jeanli-pix/test_cansat_2627/Diagramme_UML_CANSAT_2627.pdf

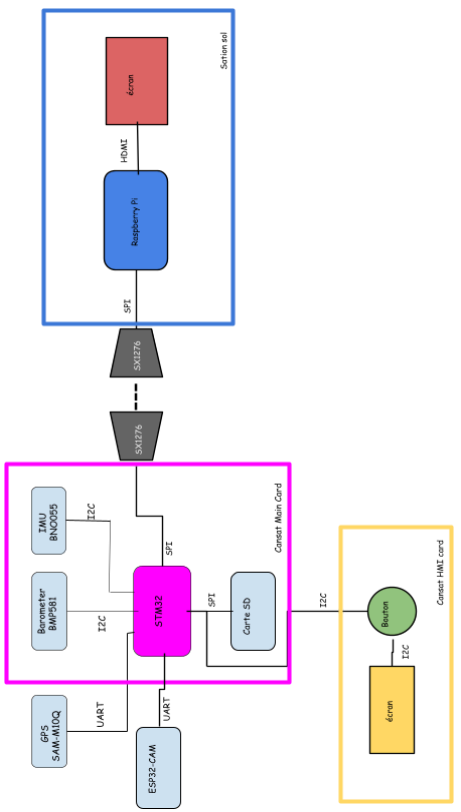
[picture p3: figure]
