jeanli-pix/test_cansat_2627/Cansat_PCB_V3/Cansat_PCB_V3.kicad_sch

## KiCad design Cansat_PCB_V3/Cansat_PCB_V3.kicad_sch (2026-11-03)

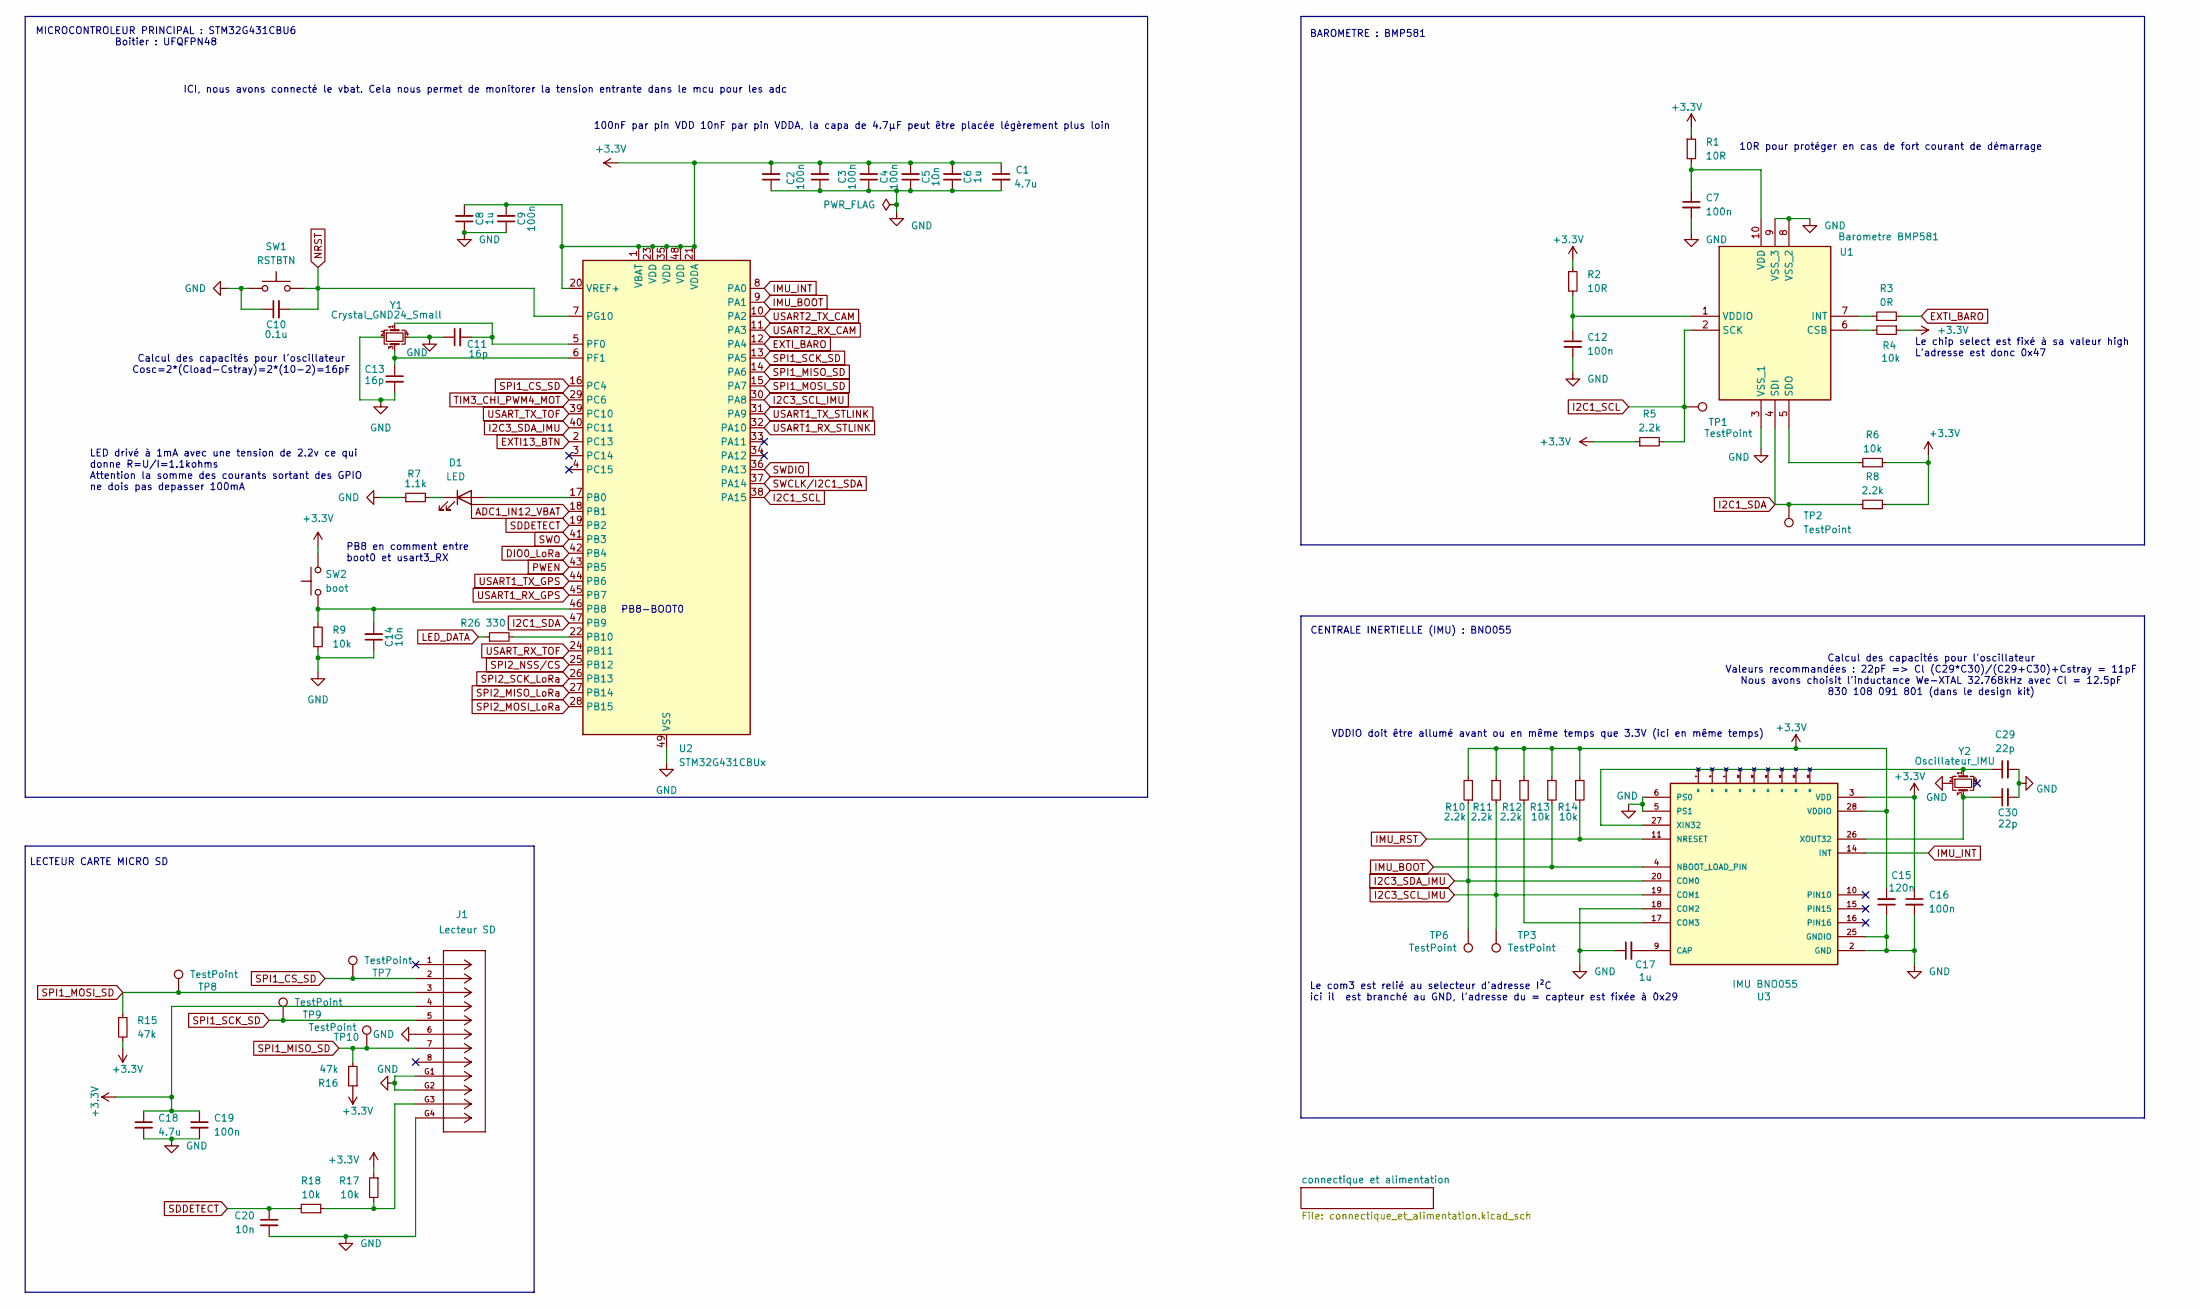
[picture p6: schematic Cansat_PCB_V3.kicad_sch]

Parts:
C1, C18: 4.7u; C_0402_1005Metric_Pad0.74x0.62mm_HandSolder
C2, C3, C4, C7, C9, C12, C16, C19: 100n; C_0402_1005Metric_Pad0.74x0.62mm_HandSolder
C5, C14, C20: 10n; C_0402_1005Metric_Pad0.74x0.62mm_HandSolder
C6, C8, C17: 1u; C_0402_1005Metric_Pad0.74x0.62mm_HandSolder
C10: 0.1u; C_0402_1005Metric_Pad0.74x0.62mm_HandSolder
C11, C13: 16p; C_0402_1005Metric_Pad0.74x0.62mm_HandSolder
C15: 120n; C_0402_1005Metric_Pad0.74x0.62mm_HandSolder
C29, C30: 22p; C_0402_1005Metric_Pad0.74x0.62mm_HandSolder
D1: LED; LED_0603_1608Metric_Pad1.05x0.95mm_HandSolder
J1: Lecteur SD; CONN12_47309-2651_MOL; Manufacturer_Part_Number 47309-2651
R1, R2: 10R; R_0402_1005Metric_Pad0.72x0.64mm_HandSolder
R3: 0R; R_0402_1005Metric_Pad0.72x0.64mm_HandSolder
R4, R6, R9, R13, R14, R17, R18: 10k; R_0402_1005Metric_Pad0.72x0.64mm_HandSolder
R5, R8, R10, R11, R12: 2.2k; R_0402_1005Metric_Pad0.72x0.64mm_HandSolder
R7: 1.1k; R_0402_1005Metric_Pad0.72x0.64mm_HandSolder
R15, R16: 47k; R_0402_1005Metric_Pad0.72x0.64mm_HandSolder
R26: 330; R_0402_1005Metric_Pad0.72x0.64mm_HandSolder
SW1: RSTBTN; KXT 321 LHS_CNK
SW2: boot; KXT 321 LHS_CNK
TP1, TP2, TP3, TP6, TP7, TP8, TP9, TP10: TestPoint; TestPoint_Pad_D1.0mm
U1: Barometre BMP581; BMP581; Manufacturer_Part_Number BMP581; Mouser Part Number 262-BMP581
U2: STM32G431CBUx; QFN-48-1EP_7x7mm_P0.5mm_EP5.6x5.6mm
U3: IMU BNO055; LGA28R50P4X10_380X520X100; Manufacturer_Part_Number BNO055; Mouser Part Number 262-BNO055
Y1: Crystal_GND24_Small; Crystal_SMD_3225-4pin_3.2x2.5mm
Y2: Oscillateur_IMU; WE-XTAL_IQXC-146

Connections:
+3.3V: C1.1, C2.2, C3.2, C4.2, C5.2, C6.2, C8.2, C9.2, C15.2, C16.1, C18.1, C19.1, J1.4, R1.1, R2.1, R4.1, R5.1, R6.2, R8.2, R10.2, R11.1, R12.1, R13.1, R14.1, R15.2, R16.1, R17.1, SW2.2, U2.1 (VBAT), U2.20 (VREF+), U2.21 (VDDA), U2.23 (VDD), U2.35 (VDD), U2.48 (VDD), U3.3 (VDD), U3.28 (VDDIO)
ADC1_IN12_VBAT: U2.18 (PB1)
DIO0_LoRa: U2.42 (PB4)
EXTI13_BTN: U2.2 (PC13)
EXTI_BARO: R3.2, U2.12 (PA4)
GND: C1.2, C2.1, C3.1, C4.1, C5.1, C6.1, C7.2, C8.1, C9.1, C10.1, C11.1, C12.2, C13.2, C14.1, C15.1, C16.2, C17.1, C18.2, C19.2, C20.2, C29.2, C30.2, J1.6, J1.G1, J1.G2, J1.G4, R7.1, R9.2, SW1.1, U1.3 (VSS_1), U1.8 (VSS_2), U1.9 (VSS_3), U2.49 (VSS), U3.2 (GND), U3.5 (PS1), U3.6 (PS0), U3.18 (COM2), U3.25 (GNDIO), Y1.2, Y1.4, Y2.2
I2C1_SCL: R5.2, TP1.1, U1.2 (SCK), U2.38 (PA15)
I2C1_SDA: R8.1, TP2.1, U1.4 (SDI), U2.47 (PB9)
I2C3_SCL_IMU: R11.2, TP3.1, U2.30 (PA8), U3.19 (COM1)
I2C3_SDA_IMU: R10.1, TP6.1, U2.40 (PC11), U3.20 (COM0)
IMU_BOOT: R13.2, U2.9 (PA1), U3.4 (NBOOT_LOAD_PIN)
IMU_INT: U2.8 (PA0), U3.14 (INT)
IMU_RST: R14.2, U3.11 (NRESET)
LED_DATA: R26.1
NRST: C10.2, SW1.2, U2.7 (PG10)
unnamed: C7.1, R1.2, U1.10 (VDD)
unnamed: C11.2, U2.5 (PF0), Y1.1
unnamed: C12.1, R2.2, U1.1 (VDDIO)
unnamed: C13.1, U2.6 (PF1), Y1.3
unnamed: C14.2, R9.1, SW2.1, U2.46 (PB8)
unnamed: C17.2, U3.9 (CAP)
unnamed: C29.1, U3.27 (XIN32), Y2.1
unnamed: C30.1, U3.26 (XOUT32), Y2.3
unnamed: D1.1 (K), R7.2
unnamed: D1.2 (A), U2.17 (PB0)
unnamed: J1.G3, R17.2, R18.1
unnamed: R3.1, U1.7 (INT)
unnamed: R4.2, U1.6 (CSB)
unnamed: R6.1, U1.5 (SDO)
unnamed: R12.2, U3.17 (COM3)
unnamed: R26.2, U2.22 (PB10)
PWEN: U2.43 (PB5)
SDDETECT: C20.1, R18.2, U2.19 (PB2)
SPI1_CS_SD: J1.2, TP7.1, U2.16 (PC4)
SPI1_MISO_SD: J1.7, R16.2, TP10.1, U2.14 (PA6)
SPI1_MOSI_SD: J1.3, R15.1, TP8.1, U2.15 (PA7)
SPI1_SCK_SD: J1.5, TP9.1, U2.13 (PA5)
SPI2_MISO_LoRa: U2.27 (PB14)
SPI2_MOSI_LoRa: U2.28 (PB15)
SPI2_NSS/CS: U2.25 (PB12)
SPI2_SCK_LoRa: U2.26 (PB13)
SWCLK/I2C1_SDA: U2.37 (PA14)
SWDIO: U2.36 (PA13)
SWO: U2.41 (PB3)
TIM3_CHI_PWM4_MOT: U2.29 (PC6)
USART1_RX_GPS: U2.45 (PB7)
USART1_RX_STLINK: U2.32 (PA10)
USART1_TX_GPS: U2.44 (PB6)
USART1_TX_STLINK: U2.31 (PA9)
USART2_RX_CAM: U2.11 (PA3)
USART2_TX_CAM: U2.10 (PA2)
USART_RX_TOF: U2.24 (PB11)
USART_TX_TOF: U2.39 (PC10)

Notes on the sheet:
BAROMETRE : BMP581
100nF par pin VDD 10nF par pin VDDA, la capa de 4.7µF peut être placée légèrement plus loin
Le com3 est relié au selecteur d'adresse I²C ici il est branché au GND, l'adresse du = capteur est fixée à 0x29
Calcul des capacités pour l'oscillateur Cosc=2*(Cload-Cstray)=2*(10-2)=16pF
10R pour protéger en cas de fort courant de démarrage
Le chip select est fixé à sa valeur high L'adresse est donc 0x47
VDDIO doit être allumé avant ou en même temps que 3.3V (ici en même temps)
Calcul des capacités pour l'oscillateur Valeurs recommandées : 22pF => Cl (C29*C30)/(C29+C30)+Cstray = 11pF Nous avons choisit l'inductance We-XTAL 32.768kHz avec Cl = 12.5pF 830 108 091 801 (dans le design kit)
MICROCONTROLEUR PRINCIPAL : STM32G431CBU6 Boitier : UFQFPN48
CENTRALE INERTIELLE (IMU) : BNO055
PB8-BOOT0
PB8 en comment entre boot0 et usart3_RX
ICI, nous avons connecté le vbat. Cela nous permet de monitorer la tension entrante dans le mcu pour les adc
LED drivé à 1mA avec une tension de 2.2v ce qui donne R=U/I=1.1kohms Attention la somme des courants sortant des GPIO ne dois pas depasser 100mA
LECTEUR CARTE MICRO SD
