jeanli-pix/test_cansat_2627/Cansat_PCB_V3/connectique_et_alimentation.kicad_sch

## KiCad design Cansat_PCB_V3/connectique_et_alimentation.kicad_sch (2026-11-03)

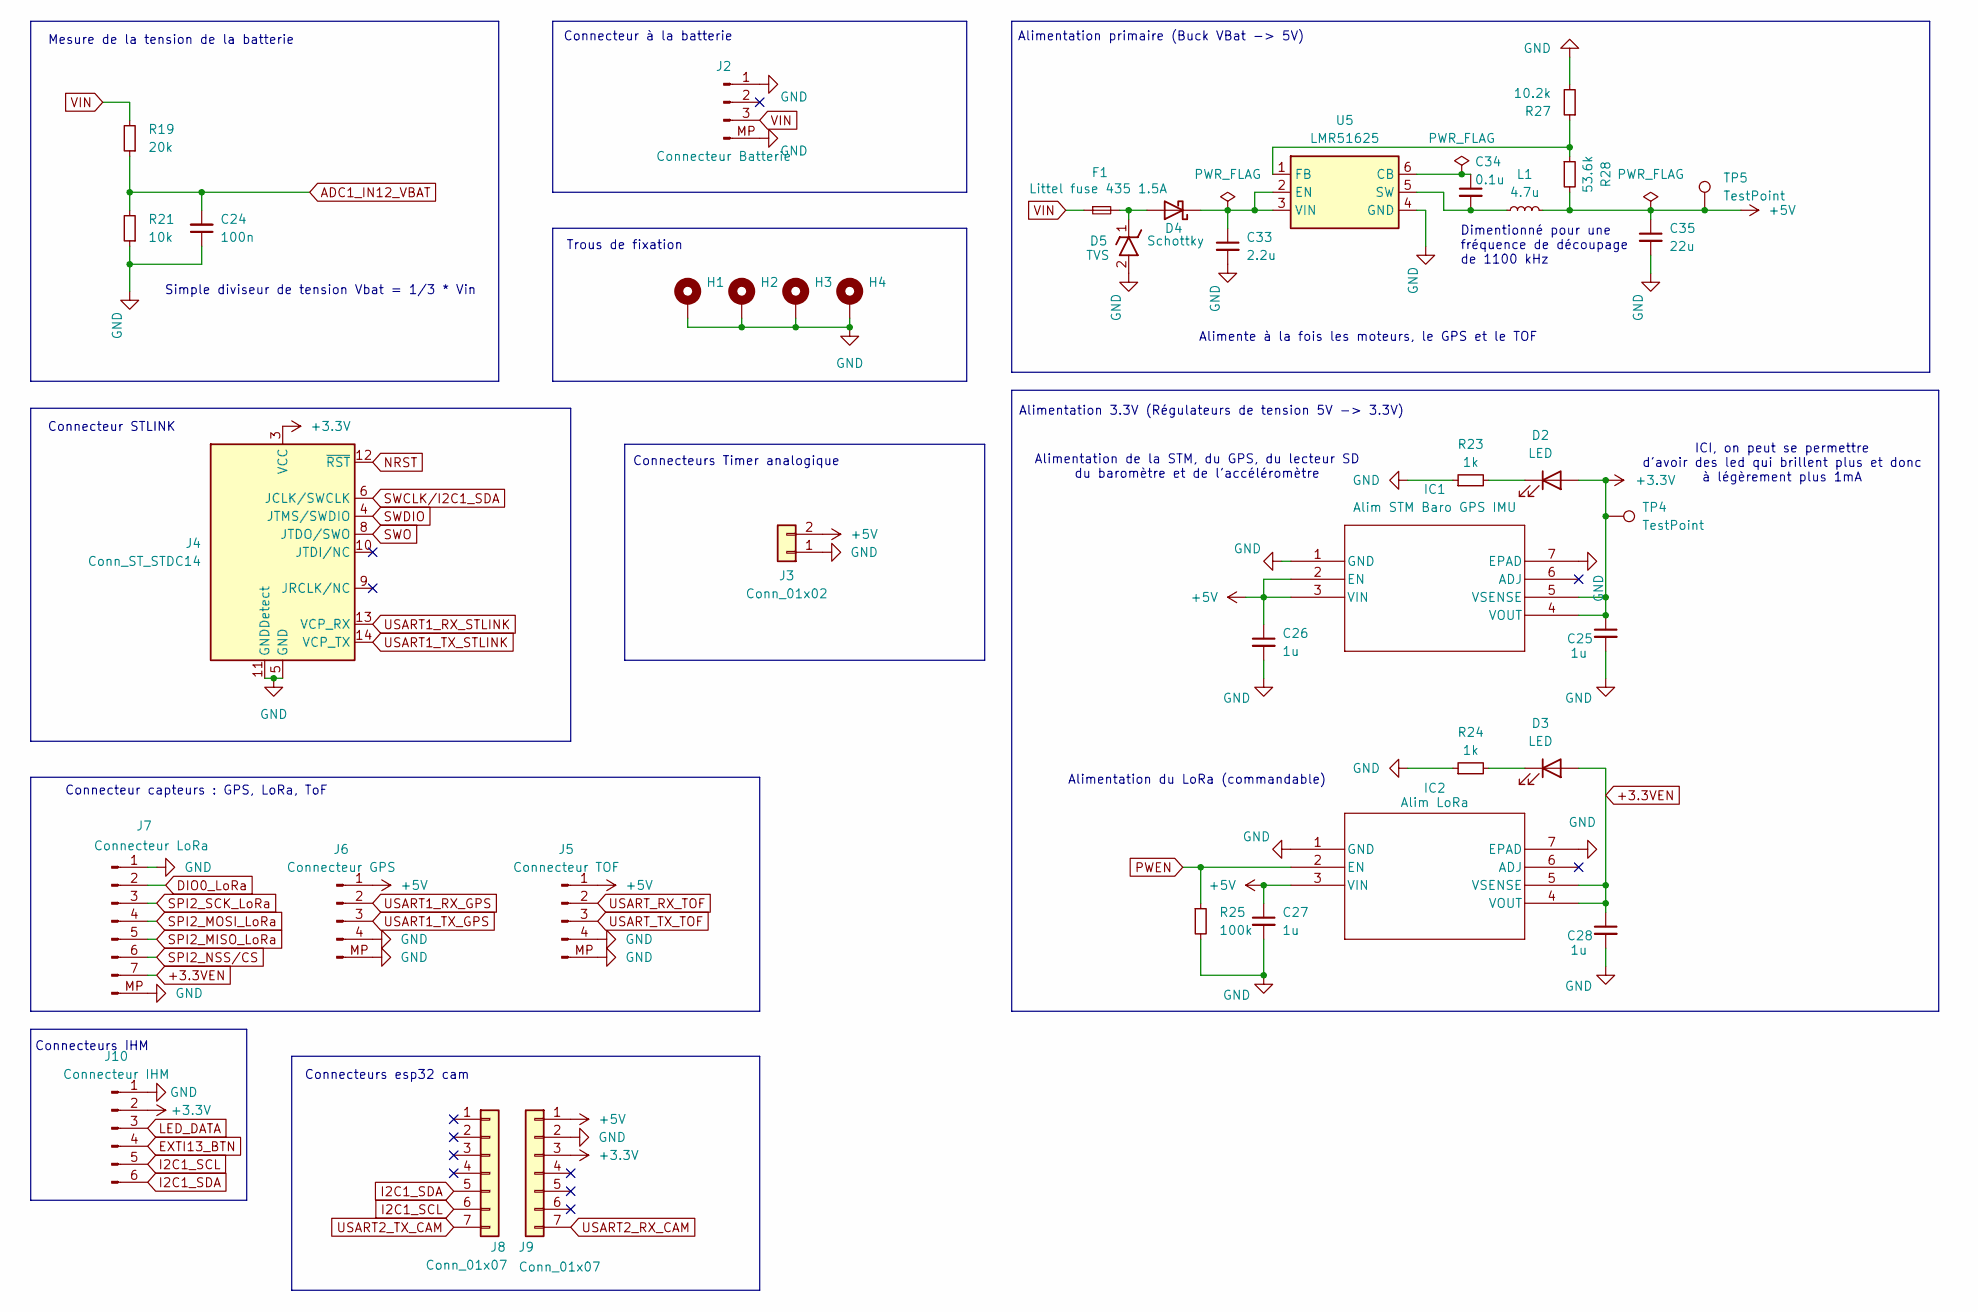
[picture p7: schematic connectique_et_alimentation.kicad_sch]

Parts:
C24: 100n; C_0402_1005Metric_Pad0.74x0.62mm_HandSolder
C25, C26, C27, C28: 1u; C_0402_1005Metric_Pad0.74x0.62mm_HandSolder
C33: 2.2u; C_0402_1005Metric_Pad0.74x0.62mm_HandSolder
C34: 0.1u; C_0402_1005Metric_Pad0.74x0.62mm_HandSolder
C35: 22u; C_0805_2012Metric_Pad1.18x1.45mm_HandSolder
D2, D3: LED; LED_0603_1608Metric_Pad1.05x0.95mm_HandSolder
D4: Schottky; D_SOD-882D
D5: TVS; SPHV12-01ETG; Manufacturer_Part_Number SPHV12-01ETG
F1: Littel fuse 435 1.5A; FUSC1608X43N
H1, H2, H3, H4: MountingHole_Pad; MountingHole_2.2mm_M2_ISO7380_Pad
IC1: Alim STM Baro GPS IMU; DFN6_3X3_STM; Manufacturer_Part_Number LDO40LPU33RY; Mouser Part Number 511-LDO40LPU33RY
IC2: Alim LoRa; DFN6_3X3_STM; Manufacturer_Part_Number LDO40LPU33RY; Mouser Part Number 511-LDO40LPU33RY
J2: Connecteur Batterie; JST_SH_BM03B-SRSS-TB_1x03-1MP_P1.00mm_Vertical
J3: Conn_01x02
J4: Conn_ST_STDC14
J5: Connecteur TOF; JST_SH_BM04B-SRSS-TB_1x04-1MP_P1.00mm_Vertical
J6: Connecteur GPS; JST_SH_BM04B-SRSS-TB_1x04-1MP_P1.00mm_Vertical
J7: Connecteur LoRa; JST_SH_BM07B-SRSS-TB_1x07-1MP_P1.00mm_Vertical
J8, J9: Conn_01x07
J10: Connecteur IHM; JST_SH_BM06B-SRSS-TB_1x06-1MP_P1.00mm_Vertical
L1: 4.7u; IND_WE-MAPI_4020_WRE
R19: 20k; R_0402_1005Metric_Pad0.72x0.64mm_HandSolder
R21: 10k; R_0402_1005Metric_Pad0.72x0.64mm_HandSolder
R23, R24: 1k; R_0402_1005Metric_Pad0.72x0.64mm_HandSolder
R25: 100k; R_0402_1005Metric_Pad0.72x0.64mm_HandSolder
R27: 10.2k; R_0402_1005Metric_Pad0.72x0.64mm_HandSolder
R28: 53.6k; R_0402_1005Metric_Pad0.72x0.64mm_HandSolder
TP4, TP5: TestPoint; TestPoint_Pad_1.5x1.5mm
U5: LMR51625; SOT-23-6

Connections:
+3.3V: C25.1, D2.2 (A), IC1.4 (VOUT), IC1.5 (VSENSE), J4.3 (VCC), J9.3, J10.2, TP4.1
+3.3VEN: C28.1, D3.2 (A), IC2.4 (VOUT), IC2.5 (VSENSE), J7.7
+5V: C26.1, C27.1, C35.1, IC1.2 (EN), IC1.3 (VIN), IC2.3 (VIN), J3.2, J5.1, J6.1, J9.1, L1.2, R28.2, TP5.1
ADC1_IN12_VBAT: C24.2, R19.1, R21.2
DIO0_LoRa: J7.2
EXTI13_BTN: J10.4
GND: C24.1, C25.2, C26.2, C27.2, C28.2, C33.2, C35.2, D5.2 (A), H1.1, H2.1, H3.1, H4.1, IC1.1 (GND), IC1.7 (EPAD), IC2.1 (GND), IC2.7 (EPAD), J2.1, J2.MP, J3.1, J4.5 (GND), J4.7 (GND), J4.11 (GNDDetect), J5.4, J5.MP, J6.4, J6.MP, J7.1, J7.MP, J9.2, J10.1, R21.1, R23.1, R24.1, R25.2, R27.2, U5.4 (GND)
I2C1_SCL: J8.6, J10.5
I2C1_SDA: J8.5, J10.6
LED_DATA: J10.3
NRST: J4.12 (~RST)
unnamed: C33.1, D4.1 (K), U5.2 (EN), U5.3 (VIN)
unnamed: C34.1, U5.6 (CB)
unnamed: C34.2, L1.1, U5.5 (SW)
unnamed: D2.1 (K), R23.2
unnamed: D3.1 (K), R24.2
unnamed: D4.2 (A), D5.1 (K), F1.2
unnamed: R27.1, R28.1, U5.1 (FB)
PWEN: IC2.2 (EN), R25.1
SPI2_MISO_LoRa: J7.5
SPI2_MOSI_LoRa: J7.4
SPI2_NSS/CS: J7.6
SPI2_SCK_LoRa: J7.3
SWCLK/I2C1_SDA: J4.6 (JCLK/SWCLK)
SWDIO: J4.4 (JTMS/SWDIO)
SWO: J4.8 (JTDO/SWO)
USART1_RX_GPS: J6.2
USART1_RX_STLINK: J4.13 (VCP_RX)
USART1_TX_GPS: J6.3
USART1_TX_STLINK: J4.14 (VCP_TX)
USART2_RX_CAM: J9.7
USART2_TX_CAM: J8.7
USART_RX_TOF: J5.2
USART_TX_TOF: J5.3
VIN: F1.1, J2.3, R19.2

Notes on the sheet:
Alimentation de la STM, du GPS, du lecteur SD du baromètre et de l'accéléromètre
Alimentation du LoRa (commandable)
Trous de fixation
Alimente à la fois les moteurs, le GPS et le TOF
Connecteurs Timer analogique
Connecteur capteurs : GPS, LoRa, ToF
Simple diviseur de tension Vbat = 1/3 * Vin
Connecteur à la batterie
Dimentionné pour une fréquence de découpage de 1100 kHz
Mesure de la tension de la batterie
ICI, on peut se permettre d'avoir des led qui brillent plus et donc à légèrement plus 1mA
Connecteurs IHM
Alimentation 3.3V (Régulateurs de tension 5V -> 3.3V)
Connecteur STLINK
Connecteurs esp32 cam
Alimentation primaire (Buck VBat -> 5V)
