jeanli-pix/test_cansat_2627/Pcb timer analogique v0/Connecteur.kicad_sch

## KiCad design Pcb timer analogique v0/Connecteur.kicad_sch (2026-11-03)

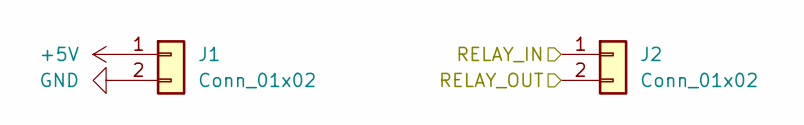
[picture p8: schematic Connecteur.kicad_sch]

Parts:
J1, J2: Conn_01x02

Connections:
+5V: J1.1
GND: J1.2
RELAY_IN: J2.1
RELAY_OUT: J2.2
