jeanli-pix/test_cansat_2627/Pcb timer analogique v0/Detection.kicad_sch

## KiCad design Pcb timer analogique v0/Detection.kicad_sch (2026-11-10)

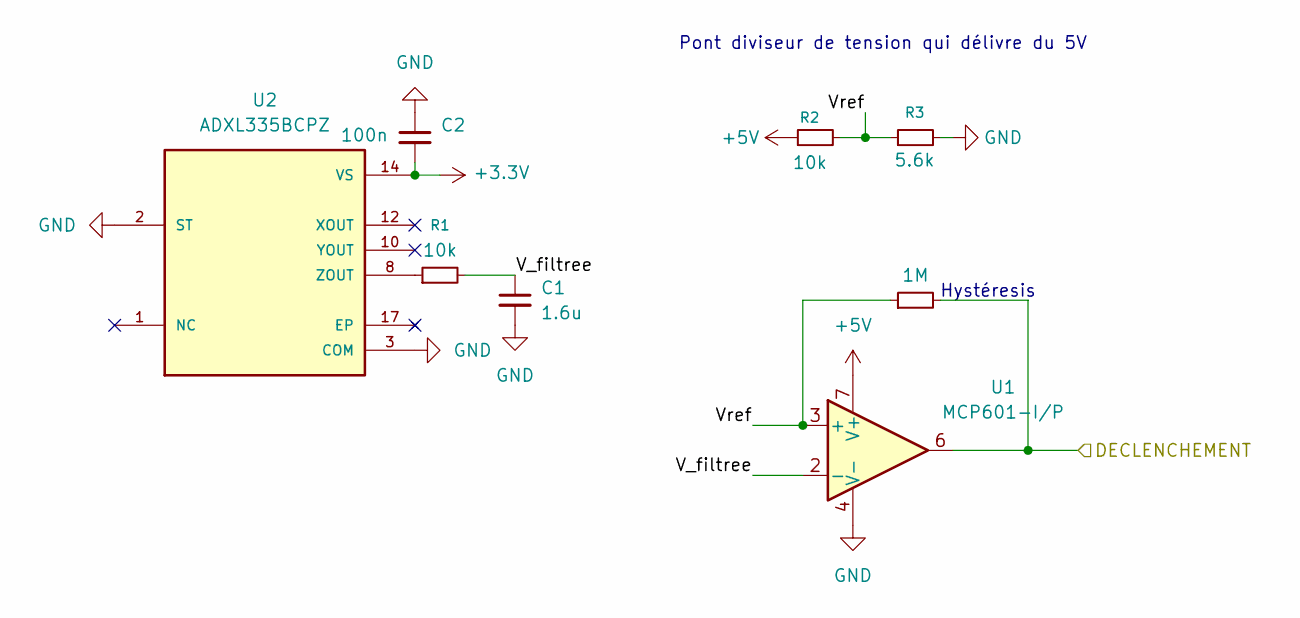
[picture p9: schematic Detection.kicad_sch]

Parts:
C1: 1.6u
C2: 100n
R1, R2: 10k
R3: 5.6k
R24: 1M
U1: MCP601-I/P; DIP-8_W7.62mm
U2: ADXL335BCPZ; PQFN65P400X400X150-17N; PARTREV B

Connections:
+3.3V: C2.2, U2.14 (VS), U2.15 (VS)
+5V: R2.1, U1.7 (V+)
DECLENCHEMENT: R24.2, U1.6
GND: C1.2, C2.1, R3.2, U1.4 (V-), U2.2 (ST), U2.3 (COM), U2.5 (COM), U2.6 (COM), U2.7 (COM)
unnamed: R1.1, U2.8 (ZOUT)
unnamed: U2.1 (NC), U2.4 (NC), U2.9 (NC), U2.11 (NC), U2.13 (NC), U2.16 (NC)
V_filtree: C1.1, R1.2, U1.2 (-)
Vref: R2.2, R3.1, R24.1, U1.3 (+)

Notes on the sheet:
Hystéresis
Pont diviseur de tension qui délivre du 5V
