jeanli-pix/test_cansat_2627/Pcb timer analogique v0/NE555.kicad_sch

## KiCad design Pcb timer analogique v0/NE555.kicad_sch (2026-11-02)

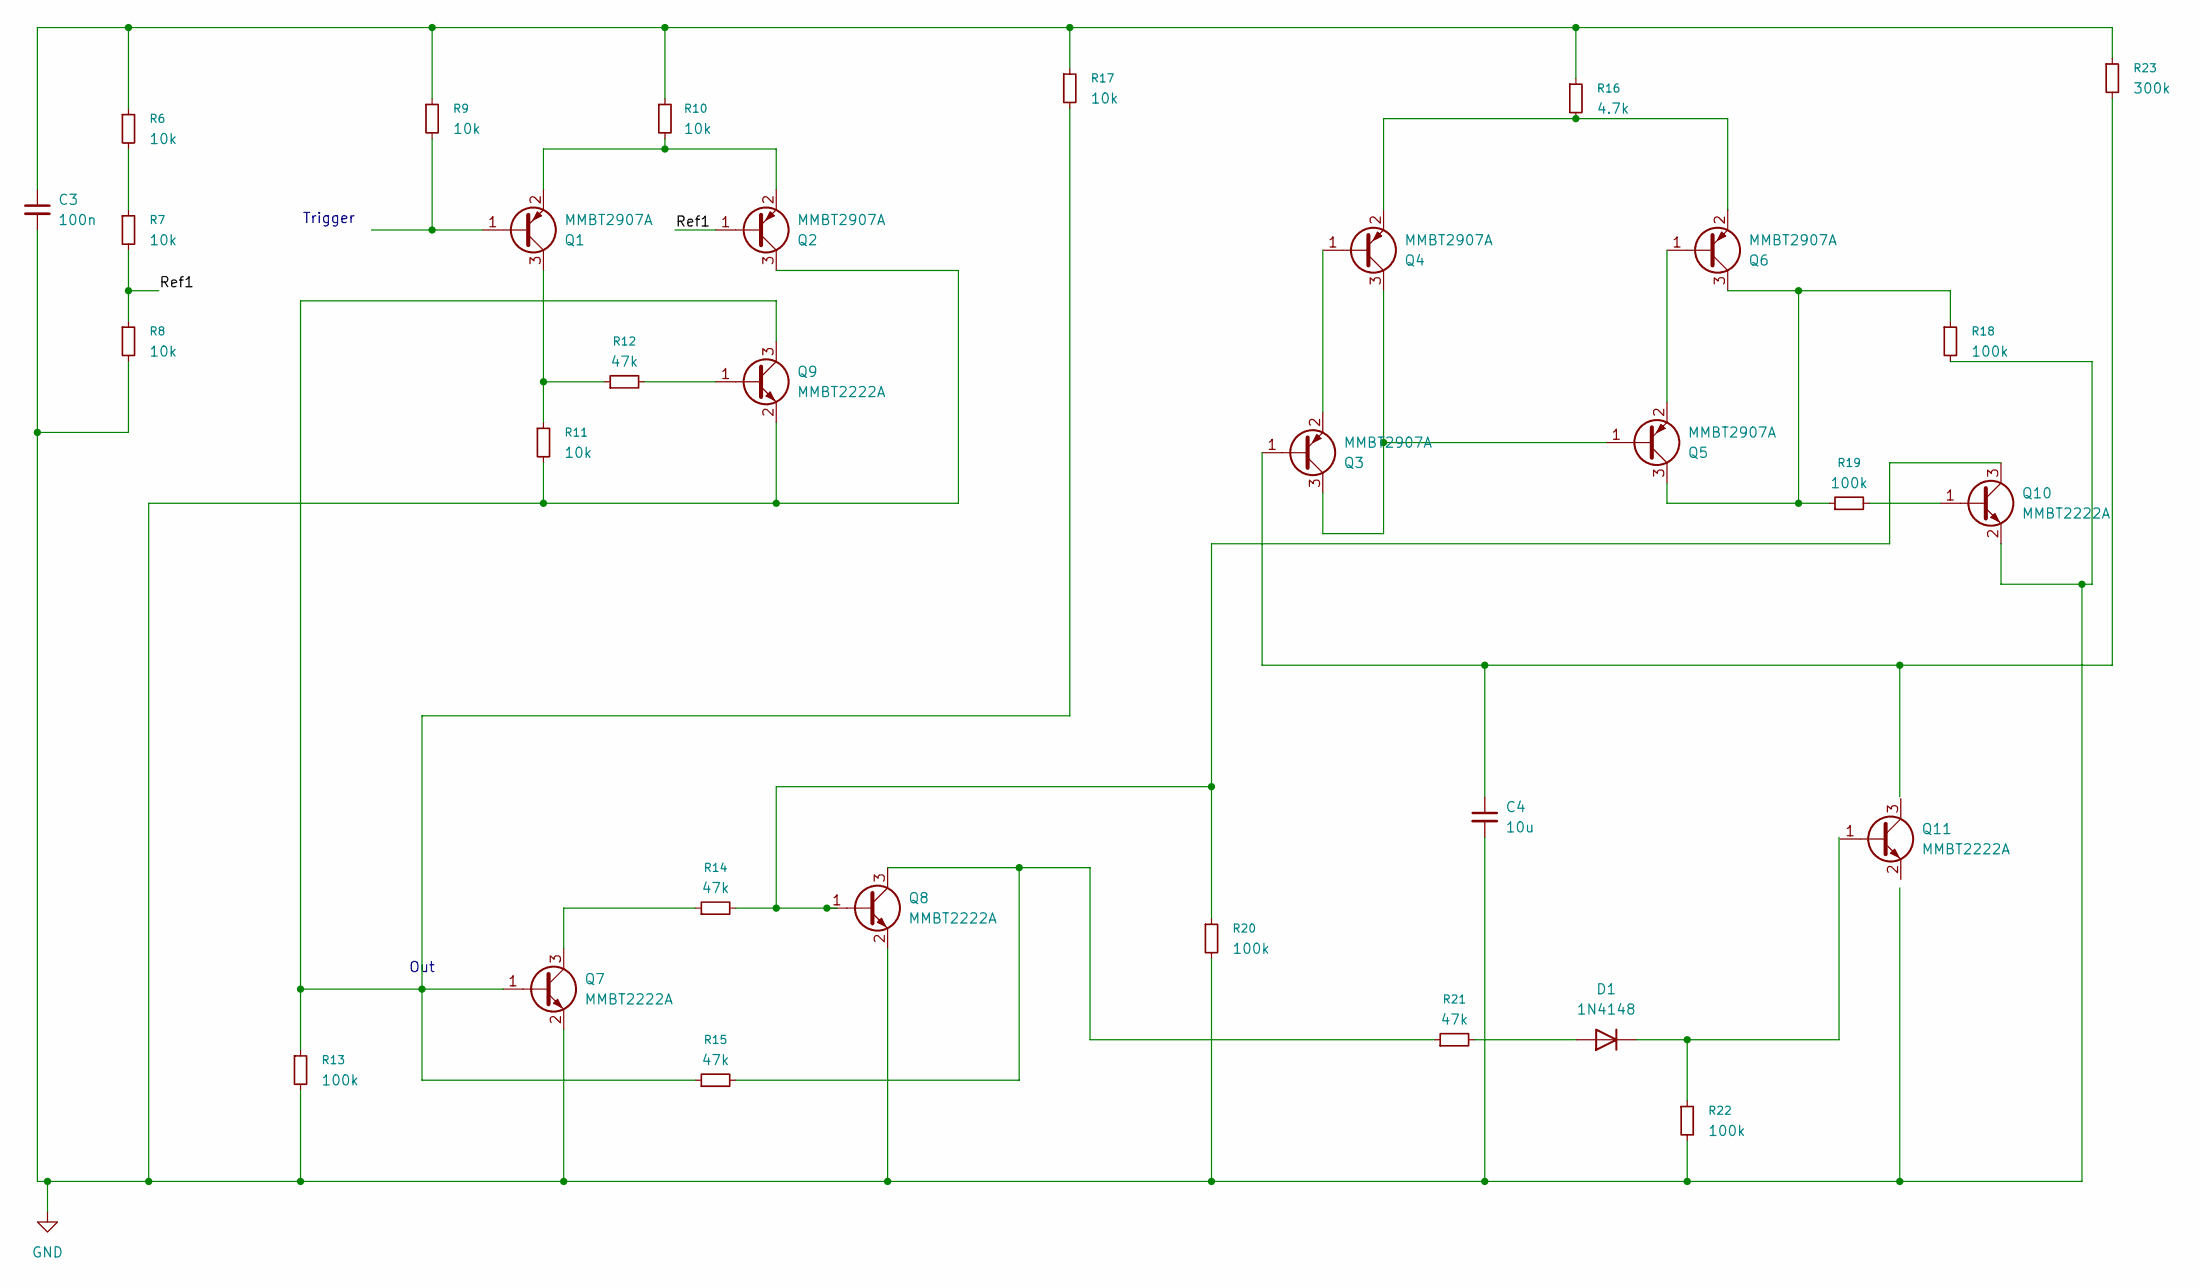
[picture p10: schematic NE555.kicad_sch]

Parts:
C3: 100n
C4: 10u
D1: 1N4148; D_DO-35_SOD27_P7.62mm_Horizontal
Q1, Q2, Q3, Q4, Q5, Q6: MMBT2907A
Q7, Q8, Q9, Q10, Q11: MMBT2222A; SOT-23
R6, R7, R8, R9, R10, R11, R17: 10k
R12, R14, R15, R21: 47k
R13, R18, R19, R20, R22: 100k
R16: 4.7k
R23: 300k

Connections:
GND: C3.2, C4.2, Q2.3 (C), Q7.2 (E), Q8.2 (E), Q9.2 (E), Q10.2 (E), R8.2, R11.2, R13.2, R18.2, R20.2, R22.2
unnamed: C3.1, R6.1, R9.1, R10.1, R16.1, R17.1, R23.1
unnamed: C4.1, Q3.1 (B), R23.2
unnamed: D1.1 (K), R22.1
unnamed: D1.2 (A), R21.2
unnamed: Q1.1 (B), R9.2
unnamed: Q1.2 (E), Q2.2 (E), R10.2
unnamed: Q1.3 (C), R11.1, R12.1
unnamed: Q3.2 (E), Q4.1 (B)
unnamed: Q3.3 (C), Q4.3 (C), Q5.1 (B)
unnamed: Q4.2 (E), Q6.2 (E), R16.2
unnamed: Q5.2 (E), Q6.1 (B)
unnamed: Q5.3 (C), Q6.3 (C), R18.1, R19.1
unnamed: Q7.1 (B), Q9.3 (C), R13.1, R15.1, R17.2
unnamed: Q7.3 (C), R14.1
unnamed: Q8.3 (C), R15.2, R21.1
unnamed: Q9.1 (B), R12.2
unnamed: Q10.1 (B), R19.2
unnamed: Q8.1 (B), Q10.3 (C), R14.2, R20.1
unnamed: R6.2, R7.1
Ref1: Q2.1 (B), R7.2, R8.1

Notes on the sheet:
Out
Trigger
