jeanli-pix/test_cansat_2627/Pcb timer analogique v0/Puissance.kicad_sch

## KiCad design Pcb timer analogique v0/Puissance.kicad_sch (2026-11-03)

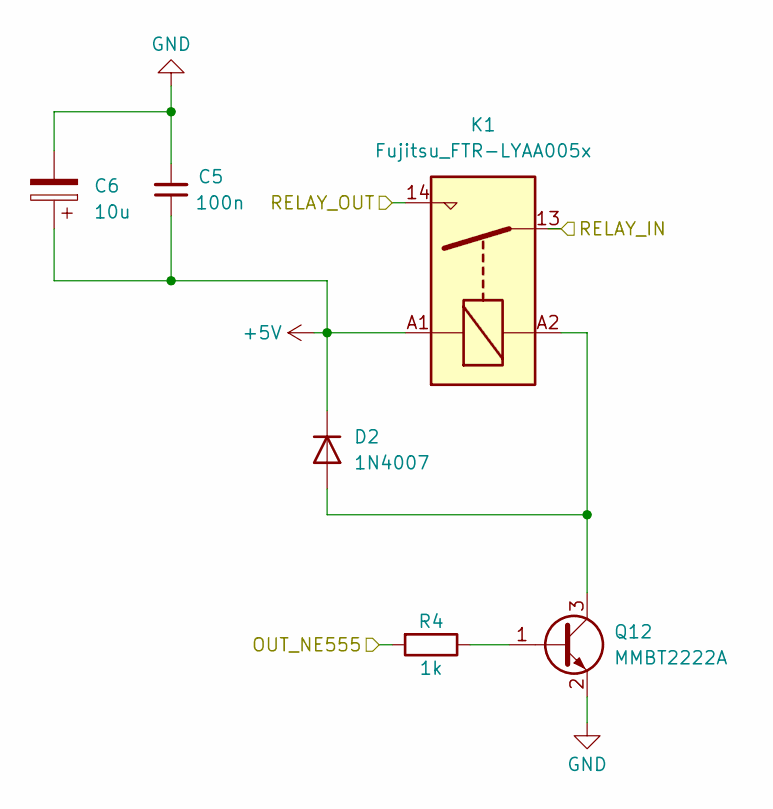
[picture p11: schematic Puissance.kicad_sch]

Parts:
C5: 100n
C6: 10u
D2: 1N4007; D_DO-41_SOD81_P10.16mm_Horizontal
K1: Fujitsu_FTR-LYAA005x; Relay_SPST-NO_Fujitsu_FTR-LYAA005x_FormA_Vertical
Q12: MMBT2222A; SOT-23
R4: 1k

Connections:
+5V: C5.1, C6.1, D2.1 (K), K1.A1
GND: C5.2, C6.2, Q12.2 (E)
unnamed: D2.2 (A), K1.A2, Q12.3 (C)
unnamed: Q12.1 (B), R4.1
OUT_NE555: R4.2
RELAY_IN: K1.13
RELAY_OUT: K1.14
