jeanli-pix/test_cansat_2627/Pcb timer analogique v0/untitled.kicad_sch

## KiCad design Pcb timer analogique v0/untitled.kicad_sch (2026-11-10)

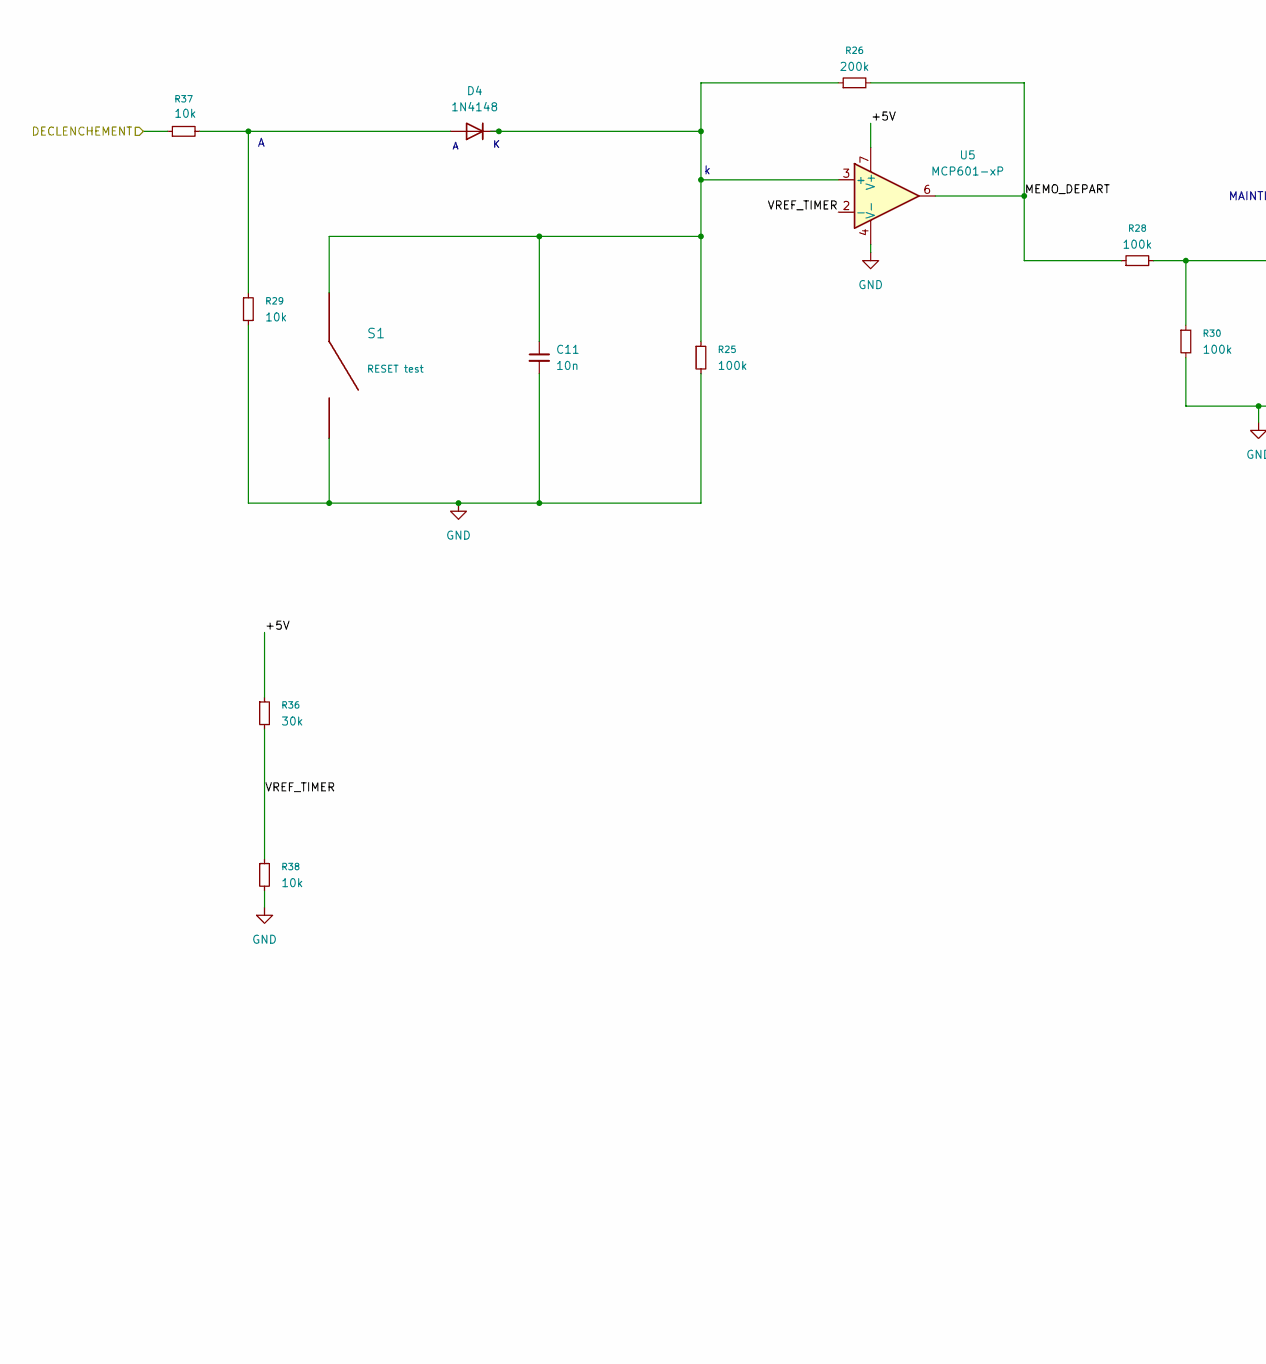
[picture p12: schematic untitled.kicad_sch, part in row 1, column 1]

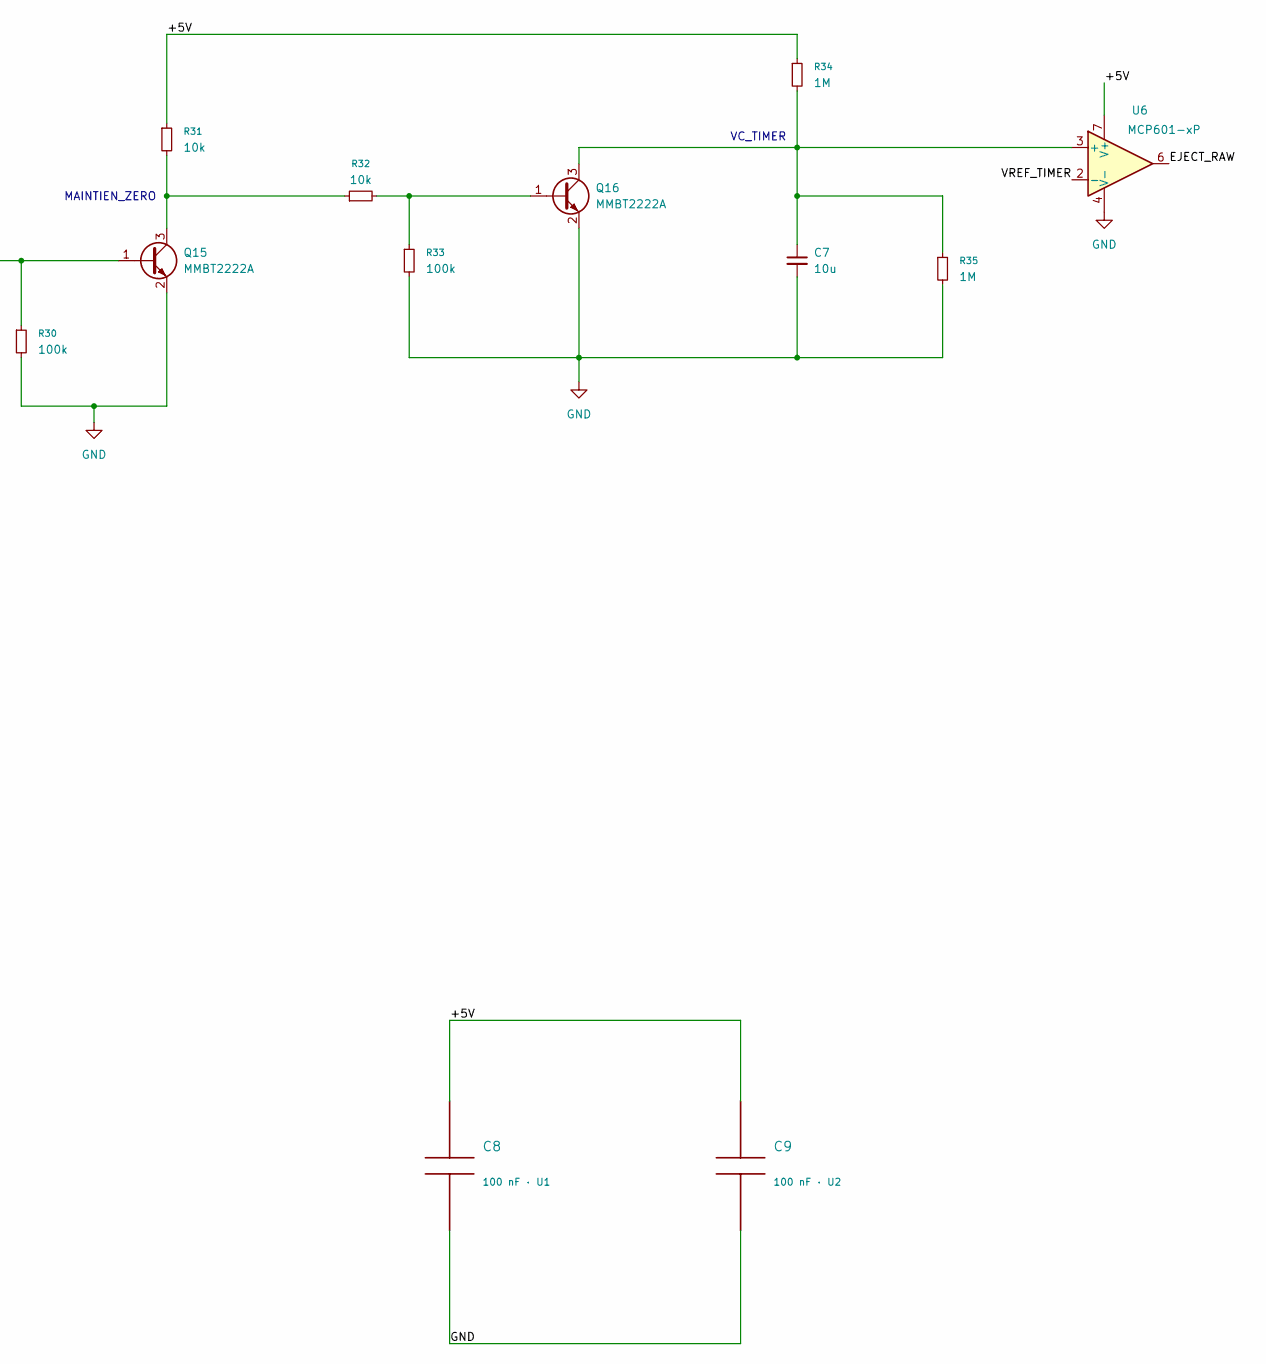
[picture p13: schematic untitled.kicad_sch, part in row 1, column 2]

Parts:
C7: 10u
C8: 100 nF · U1
C9: 100 nF · U2
C11: 10n
D4: 1N4148; D_DO-35_SOD27_P7.62mm_Horizontal
Q15, Q16: MMBT2222A; SOT-23
R25, R28, R30, R33: 100k
R26: 200k
R29, R31, R32, R37, R38: 10k
R34, R35: 1M
R36: 30k
S1: RESET test
U5, U6: MCP601-xP; DIP-8_W7.62mm

Connections:
+5V: C8.1, C9.1, R31.1, R34.1, R36.1, U5.7 (V+), U6.7 (V+)
DECLENCHEMENT: R37.1
EJECT_RAW: U6.6
GND: C7.2, C8.2, C9.2, C11.2, Q15.2 (E), Q16.2 (E), R25.2, R29.2, R30.2, R33.2, R35.2, R38.2, S1.2, U5.4 (V-), U6.4 (V-)
MEMO_DEPART: R26.2, R28.1, U5.6
unnamed: C7.1, Q16.3 (C), R34.2, R35.1, U6.3 (+)
unnamed: C11.1, D4.1 (K), R25.1, R26.1, S1.1, U5.3 (+)
unnamed: D4.2 (A), R29.1, R37.2
unnamed: Q15.1 (B), R28.2, R30.1
unnamed: Q15.3 (C), R31.2, R32.1
unnamed: Q16.1 (B), R32.2, R33.1
VREF_TIMER: R36.2, R38.1, U5.2 (-), U6.2 (-)

Notes on the sheet:
MAINTIEN_ZERO
VC_TIMER
