jeanli-pix/test_cansat_2627/(commit log)

2026-09-15 Ajout de testjb.txt
2026-09-15 Test de Flo
2026-09-29 timer analogique
2026-09-29 Update timer_analogique.txt with LDR method preference
    Added preference for LDR method and additional details.
2026-09-29 Ajout du cameleon et de ecureuil
2026-09-29 Ajout de la cocinelle et de la libellule
2026-09-29 Ajout des systemes
2026-10-06 Ajout des specificités de la partie Pneumatique (Valve+tube etc...))
    Added detailed specifications for the pneumatic circuit and mechanical components of the CanSat, including the reservoir, electrovalve, pneumatic muscle, and ejection mechanism.
2026-10-20 Feuille hierarchique du timer analogique v0
2026-10-20 pcb kicad
2026-10-20 Partie detection du timer analaogique
2026-10-22 suppression de pcb_v3_backups
2026-10-22 ajout du pcb v1
2026-11-02 modif timer analogique à 14h25
2026-11-03 Feuilles 3 et 4 - PCB timer analogique
2026-11-10 nouveau timer 10/11
2026-11-10 test timer
