jeanli-pix/test_cansat_2627/Biomimétisme/biomimetisme_cocinelle_libellule.jpg

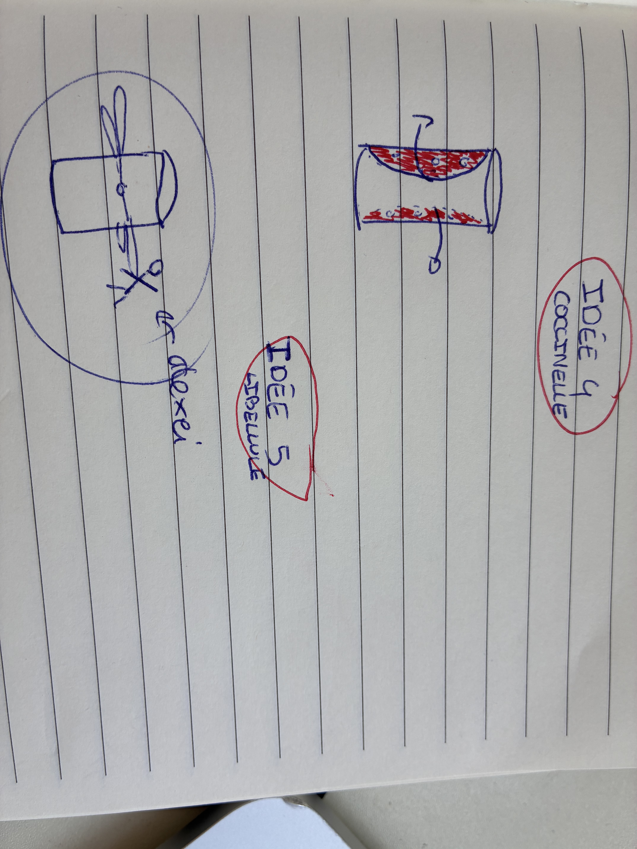
Biomimétisme/biomimetisme_cocinelle_libellule.jpg
