jeanli-pix/test_cansat_2627/Biomimétisme/biomimetisme_ecureuil_cameleon.jpg

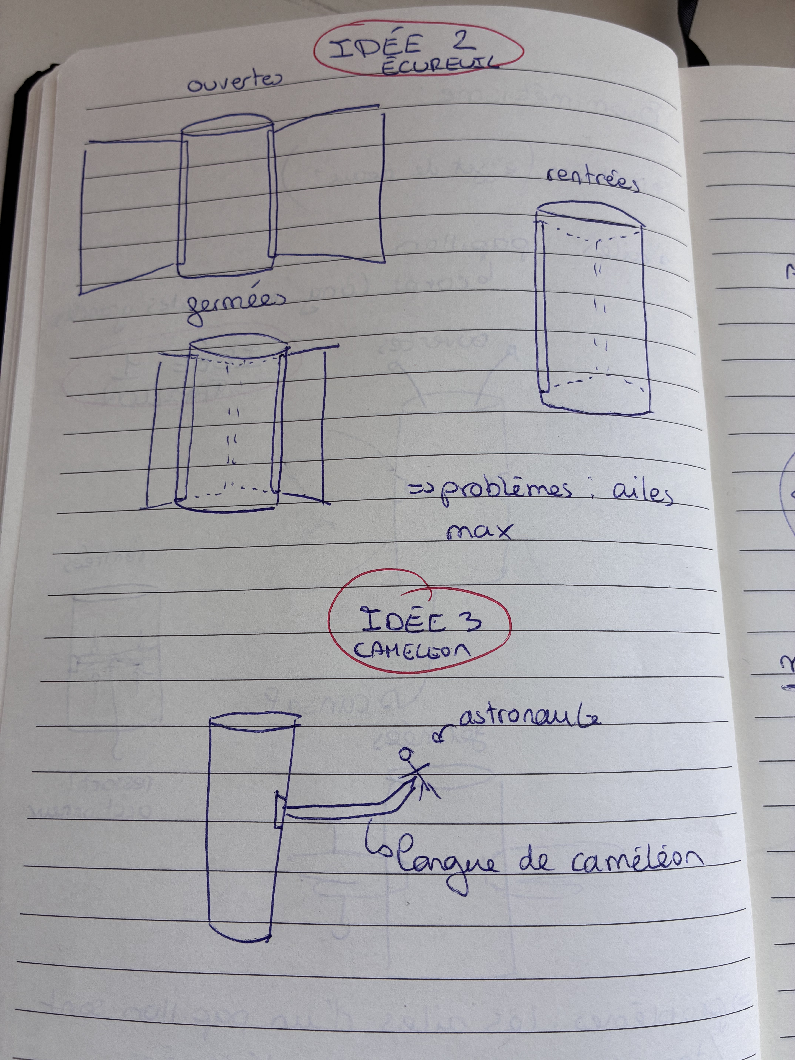
Biomimétisme/biomimetisme_ecureuil_cameleon.jpg
