jeanli-pix/test_cansat_2627/differents_systemes_deploiement.jpg

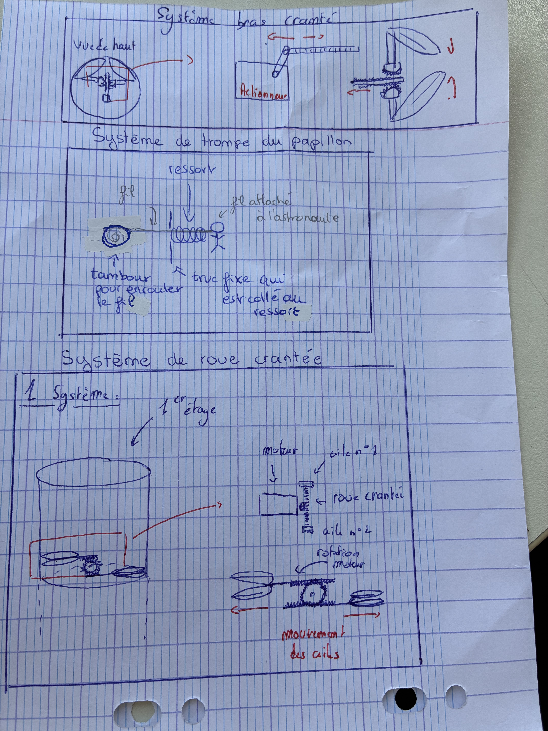
differents_systemes_deploiement.jpg
