jeanli-pix/test_cansat_2627/Biomimétisme/biomimetisme_papillon.jpg

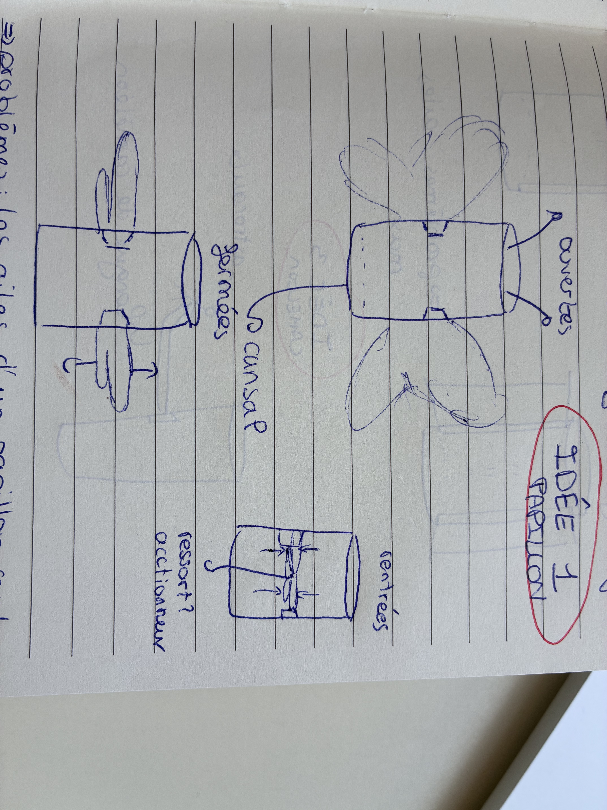
Biomimétisme/biomimetisme_papillon.jpg
